icefoxj/Tab5-Streamdeck-Neo-Stand/3mf/tab5_neo_stand_2color.3mf

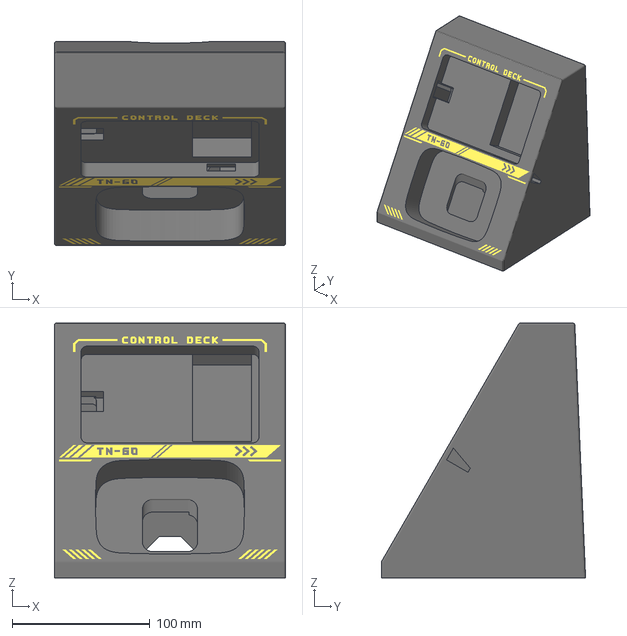
[picture p8: CAD file, 2026-11-01]
3mf/tab5_neo_stand_2color.3mf
168.0 x 148.4 x 185.4 mm
