icefoxj/Tab5-Streamdeck-Neo-Stand/stl/tab5_neo_stand.stl

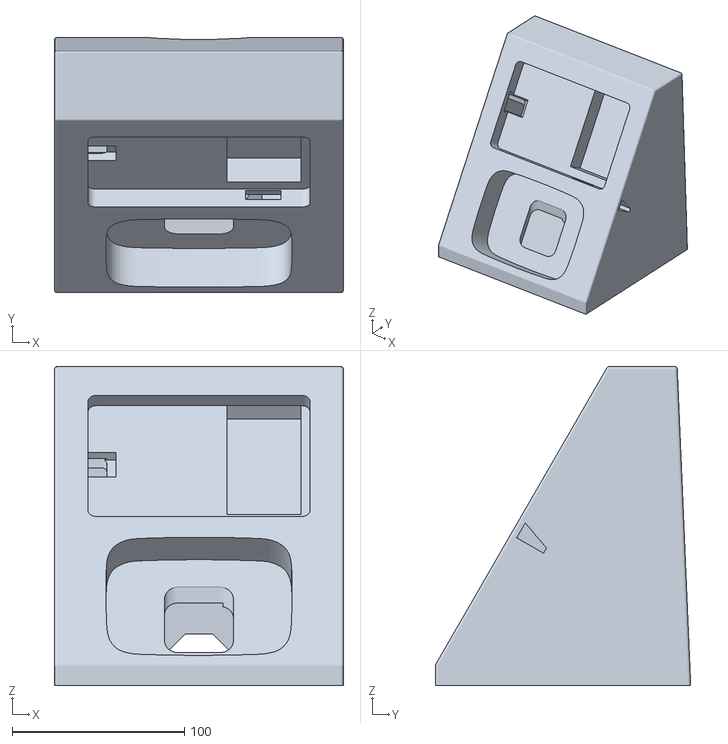
[picture p9: CAD file, 2026-11-01]
stl/tab5_neo_stand.stl
168.0 x 148.4 x 185.4
