icefoxj/Tab5-Streamdeck-Neo-Stand/(commit log)

2026-11-01 Add Tab5 + Stream Deck Neo desk stand
    Parametric 60° stand for an M5Stack Tab5 (landscape, top) and an Elgato
    Stream Deck Neo (bottom) with coplanar front faces, no front bezels,
    an NP-F550 battery notch, a speaker vent gap, and a hollow body that
    routes both cables to a rear exit. Prints upright without supports.
    Includes the generated STL, a fit/printability checker against the
    official Tab5 dimensions, preview renders, README and CLAUDE.md.
    [tab5_neo_stand.stl]
2026-11-01 Seat both devices in flush slots and hide the USB-C plug
    - Single front face: the Neo and Tab5 sit in slots as deep as they are
    thick, so both are flush with the stand.
    - Neo slot follows the real outline, traced from Elgato's official
    device model, with finger scoops to lift it out.
    - Tab5 slot has R4 corners and opens at the top; the Tab5 slides in
    while its 90° USB-C plug rides down a channel hidden under the face.
    - Speaker port vents the Tab5's bottom-edge grille through the face.
    - Solid frame around the slots, hollow body behind for the cables.
    - check_fit now verifies the plug is covered and whitelists only the
    Neo slot ceiling (60°, hidden) as an overhang.
    - README rewritt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
    [tab5_neo_stand.stl]
2026-11-01 Close the Tab5 slot with an even frame; drop the Neo finger scoops
    - The Tab5 slot is now closed, with the same 20 mm frame at the top as
    at the sides. The Tab5 goes in tilted, plug side first: the 90° plug
    hooks into the hidden channel under the left frame, then the far side
    drops in. The channel is sized from that swept motion, and the
    battery notch has room for the battery to swing out.
    - Slot clearance is now uniform (0.6 mm) so the Tab5 can tilt without
    touching the corners.
    - The Neo finger scoops are gone; tip the stand forward to remove it.
    - The cable is threaded through an opening behind the plug instead of
    a slot through the top.
    - check_fit walks the Tab5 in/out path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
    [tab5_neo_stand.stl]
2026-11-01 Route the Tab5 speaker to a side exit with a 45° ramp
    - The front speaker port is gone; the band between the slots is closed.
    - The grille fires through an opening in the slot floor into a channel
    hidden in that band. A 45° ramp at the channel's closed end, under
    the grille, turns the sound towards an exit in the right side wall.
    - The channel roof leans in as it gets deeper, so it prints without
    support. The band grows to fit the channel (stand is 4 mm taller).
    - check_fit verifies the grille -> channel -> side exit path is clear
    and that the front of the channel is closed.
    - New cutaway render of the channel; README and CLAUDE.md updated.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
    [tab5_neo_stand.stl]
2026-11-01 Add a two-colour mech-style livery as a 3MF inlay
    The face gets straight-line markings in a second filament: a title bar with
    corner brackets over the Tab5, a "TN-60" band with speed dashes and chevrons
    pointing at the speaker exit, and hazard stripes in the bottom corners. The
    livery is recessed 0.6 mm into the face; the inlay that fills it is a separate
    part, and both go into a core 3MF as one object for multi-material printers.
    The one-colour STL is unchanged.
    check_fit verifies both parts, that they add up to the one-colour stand, that
    the inlay is full depth, that strokes and gaps are wide enough to print, and
    reads the 3MF back.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
    [tab5_neo_stand_2color.3mf]
2026-11-01 Black stand with a yellow livery
    The 3MF now stores black for the stand and yellow for the ornament as core
    base materials (display colours), and the renders use the same scheme.
    check_fit also checks each part's colour when it reads the 3MF back.
    [tab5_neo_stand_2color.3mf]
